standardproducts/products/stoolone/parts/bottomPart.stl

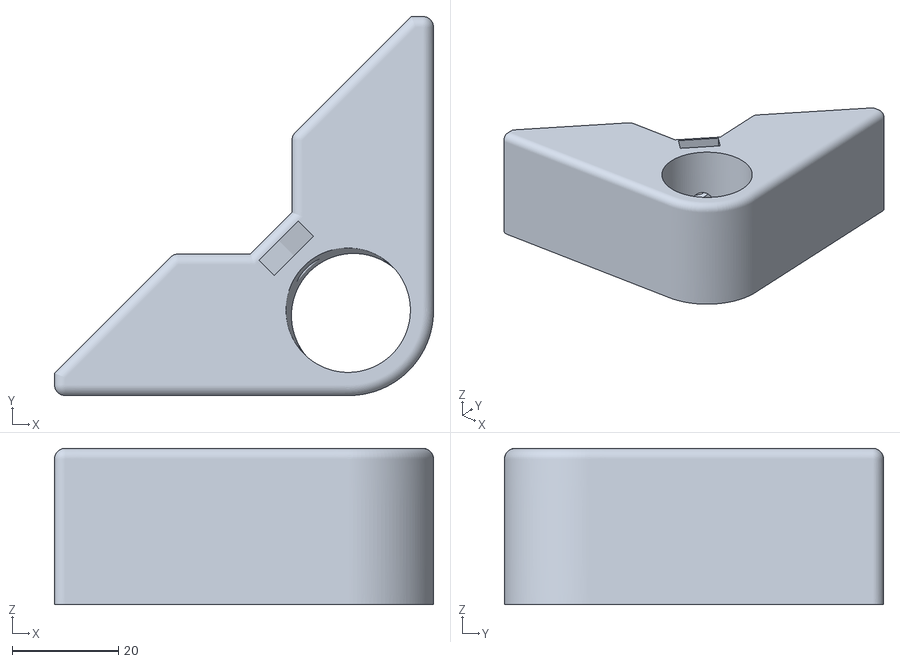
[picture p6: CAD file, 2016-11-10]
stoolone/parts/bottomPart.stl
71.3 x 71.3 x 29.4
