standardproducts/products/stoolone/parts/midPart.stl

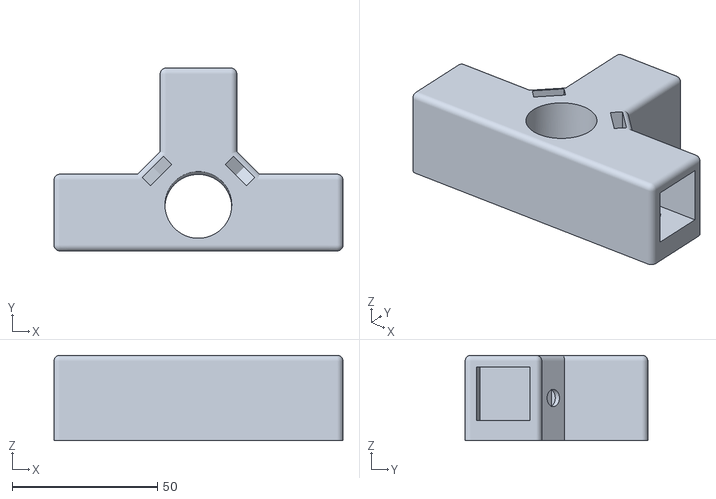
[picture p7: CAD file, 2016-11-10]
stoolone/parts/midPart.stl
99.4 x 62.9 x 29.4
