standardproducts/products/stoolone/parts/topPart.stl

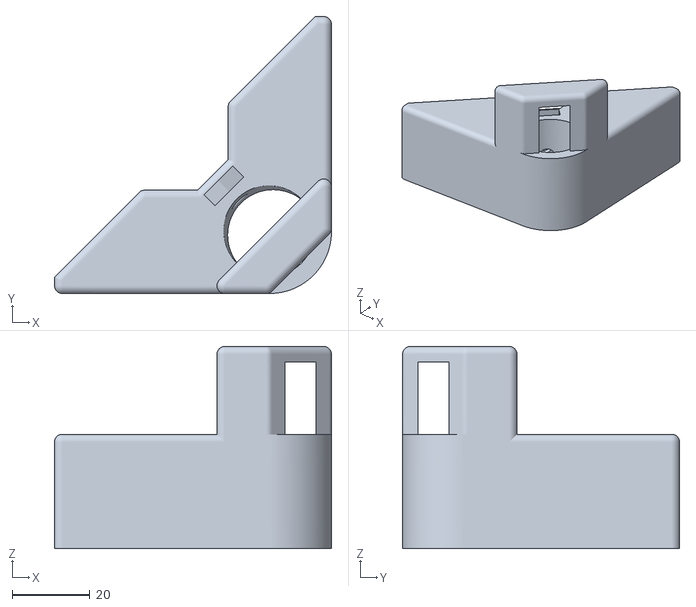
[picture p8: CAD file, 2016-11-10]
stoolone/parts/topPart.stl
71.3 x 71.3 x 52.0
